pchote/Karaka/README.md

Karaka
======

Firmware and hardware schematics for the timing hardware in the [Puoko-nui time-series photometer](http://pchote.github.io/Puoko-nui/).

See the following documents for further details:
* [Puoko-nui manual](http://pchote.github.io/Puoko-nui/images/manual-lowres.pdf).
* [Firmware logic overview](https://github.com/pchote/Karaka/blob/master/doc/firmware.pdf?raw=true).
* [Board schematic](https://github.com/pchote/Karaka/blob/master/doc/schematic.pdf?raw=true).
