pchote/Karaka/doc/schematic.pdf

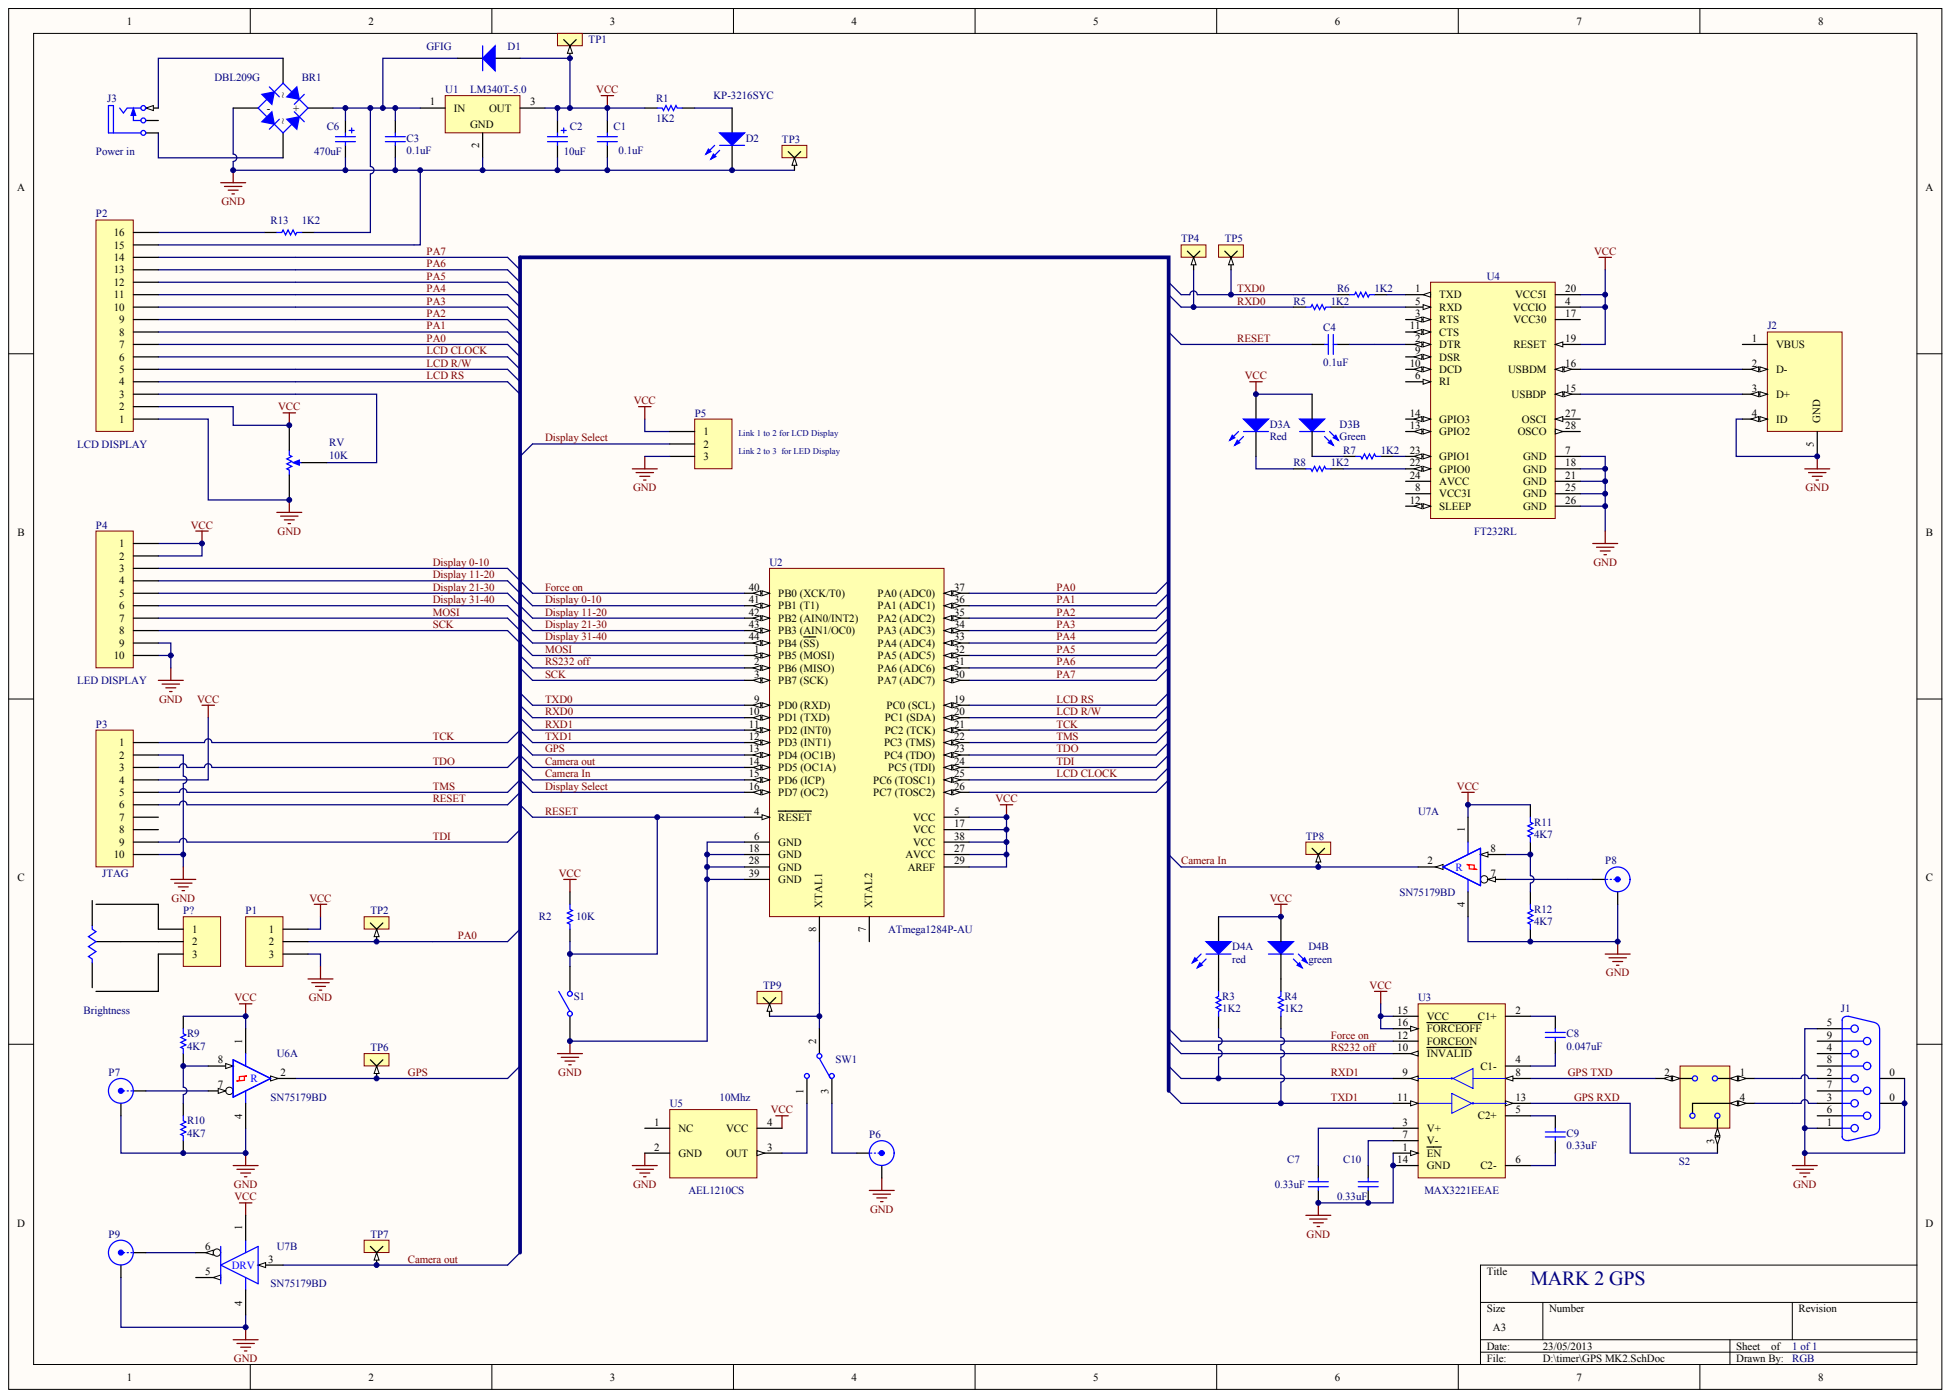
[picture p7: page 1]

Link 1 to 2 for LCD Displa

Link 2 to 3 for LED Displa
