pchote/Karaka/doc/layout.pdf

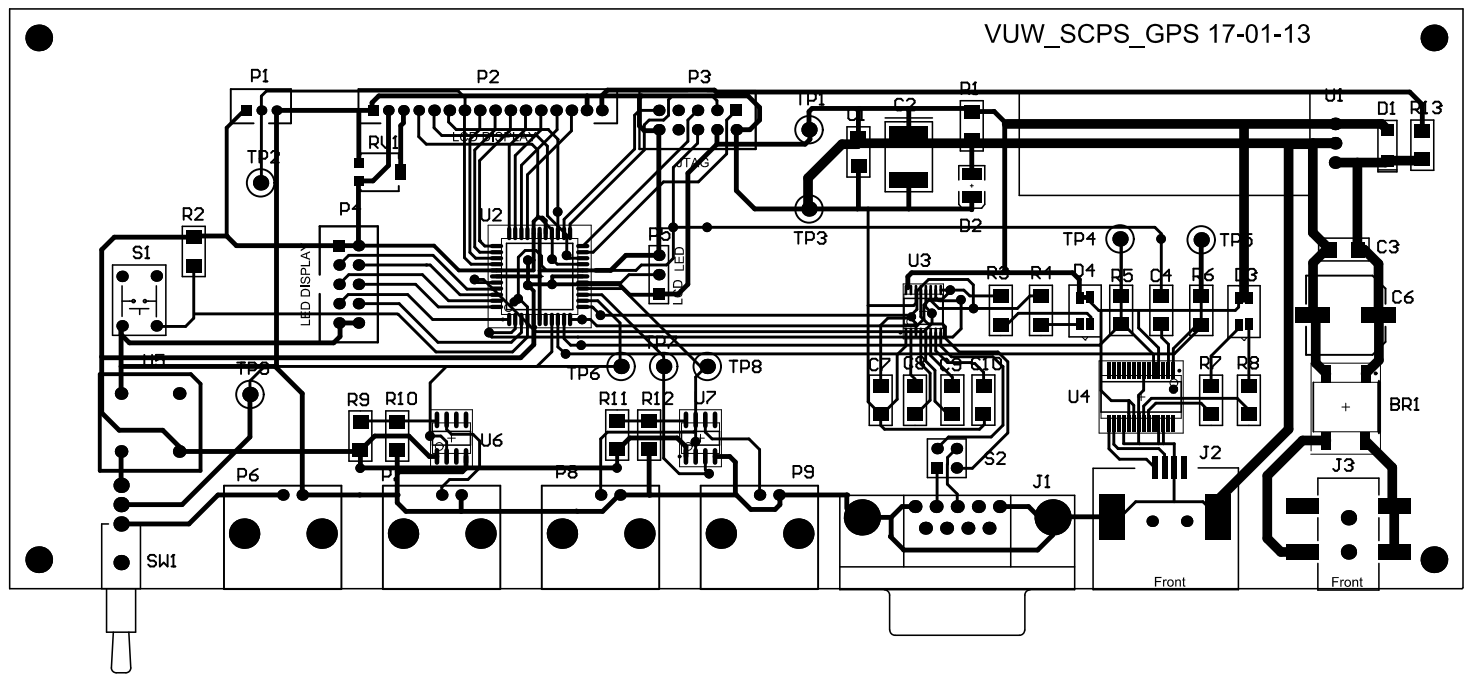
[picture p8: page 1]

Designator | Quantity | Value | Supplier 1 | Supplier Part Number 1
BR1 | 1 | DBL209G | Farnell | 1299302
C1a C3a C4 | 3 | 0.1uF
C2 | 1 | 10uF
C6 | 1 | 470uF
C7a C9a C10 | 3 | 0.33uF
C8 | 1 | 0.047uF
D1 | 1 | GFIG | Farnell | 9549595
D2 | 1 | KP-3216SYC | Farnell | 8529990
D3a D4 | 2 | | Farnell | 5790888
J1 | 1 | DB9 RA male plug | Farnell | 1099289
J2 | 1 | Connectora USB Ba SMTa R/A | Farnell | 1321918
J3 | 1 | | Farnell | 1889311
P1 | 1 | | Farnell | 4591598
P2 | 1 | | Farnell | 1830770
P3 | 1 | | Farnell | 8395918
P4 | 1 | | Farnell | 8395918
P5 | 1 | 3 x 1 berg stick 0.1 inch
P6a P7a P8a P9 | 4 | | Farnell | 1338762
R1a R3a R4a R5a R6a R7a R8a R13 | 8 | 1K2
R2 | 1 | 10K
R9a R10a R11a R12 | 4 | 4K7
RV | 1 | | Farnell | 1227539
S1 | 1 | | Farnell | 1656423
S2 | 1 | 2 x 2 berg stick 100ml
SW1 | 1 | | Farnell | 1082499
TP1a TP2a TP3a TP4a TP5a TP6a TP7a TP8a TP9 | 9 | | Farnell | 8731187
U1 | 1 | LM340T-5.0
U2 | 1 | ATmega1284P-AU | Farnell | 1715480
U3 | 1 | MAX3221EEAE | Farnell | 9725466
U4 | 1 | FT232RL | Farnell | 1146032
U5 | 1 | AEL1210CS | Farnell | 9509992
U6a U7 | 2 | SN75179BD | Farnell | 9592954
