pchote/Karaka/main.h

//***************************************************************************
//
//  File        : main.h
//  Copyright   : 2009-2012 Johnny McClymont, Paul Chote
//  Description : Main program logic
//
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
//***************************************************************************


#ifndef KARAKA_MAIN_H
#define KARAKA_MAIN_H

#include <string.h>
#include <stdint.h>
#include <stdbool.h>
#include <avr/io.h>

enum timing_mode
{
    MODE_PULSECOUNTER = 0,
    MODE_HIGHRES = 1,
};

extern uint8_t timing_mode;

// Run millisecond timer without a prescaler:
//   each tick is 0.1000us at 10MHz
//   each tick is 0.0625us at 16MHz
#define STOP_MILLISECOND_TIMER (TCCR1B = _BV(WGM12))
#define START_MILLISECOND_TIMER (TCCR1B = _BV(WGM12)|_BV(CS10))

// Bootloader bypass EEPROM parameters - must match definitions in bootloader.c
#define BOOTLOADER_EEPROM_OFFSET (uint8_t *)(0x00)
#define BYPASS_DISABLED 0xFF
#define BYPASS_ENABLED 0x42

// Relay mode EEPROM parameters
#define RELAY_EEPROM_OFFSET (uint8_t *)(0x01)
#define RELAY_DISABLED 0xFF
#define RELAY_ENABLED 0x42

extern uint16_t exposure_total;
extern volatile uint16_t exposure_countdown;
extern uint8_t trigger_stride;
extern volatile uint8_t trigger_countdown;
extern uint8_t align_boundary;
extern volatile uint16_t millisecond_count;

enum message_flags
{
    FLAG_SEND_STATUS       = _BV(0),
    FLAG_STOP_EXPOSURE     = _BV(1),
    FLAG_SEND_TIMESTAMP    = _BV(2),
    FLAG_SEND_TRIGGER      = _BV(3),
    FLAG_TIME_DRIFT        = _BV(4),
    FLAG_DUPLICATE_PULSE   = _BV(5),
    FLAG_MISSING_PULSE     = _BV(6),
};

extern volatile enum message_flags message_flags;

enum timestamp_flags
{
    TIMESTAMP_LOCKED = _BV(0),
    TIMESTAMP_IS_GPS = _BV(1)
};

struct timestamp
{
    uint16_t year;
    uint8_t month;
    uint8_t day;
    uint8_t hours;
    uint8_t minutes;
    uint8_t seconds;
    uint16_t milliseconds;
    enum timestamp_flags flags;
    int16_t utc_offset;
    uint16_t exposure_progress;
};

extern volatile struct timestamp download_timestamp;
extern struct timestamp current_timestamp;

enum timer_status
{
    TIMER_IDLE,
    TIMER_WAITING,
    TIMER_ALIGN,
    TIMER_EXPOSING,
    TIMER_READOUT,
    TIMER_RELAY
};

extern volatile enum timer_status timer_status;
void set_timer_status(enum timer_status status);

enum gps_status
{
    GPS_UNAVAILABLE = 0,
    GPS_SYNCING     = 1,
    GPS_ACTIVE      = 2
};

extern volatile enum gps_status gps_status;
void set_gps_status(enum gps_status status);

void set_time(struct timestamp *t);

#endif
