pchote/Karaka/usb.h

//***************************************************************************
//
//  File        : usb.h
//  Copyright   : 2013 Paul Chote
//  Description : Handles communication with the Acquisition PC via serial
//
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
//***************************************************************************

#include <stdarg.h>
#include <stdint.h>

#ifndef KARAKA_USB_H
#define KARAKA_USB_H

void usb_initialize();
void usb_tick();

void usb_send_message_P(const char *string);
void usb_send_message_fmt_P(const char *fmt, ...);
void usb_send_raw(uint8_t *data, uint8_t length);
void usb_send_timestamp();
void usb_send_trigger();
void usb_send_status(enum timer_status timer, enum gps_status gps);
void usb_stop_exposure();

void usb_send_byte(uint8_t b);

#endif
