pchote/Karaka/(commit log)

2011-01-13 Rename timer2 -> msec_timer.
2011-01-14 Rename timer0 -> sync_pulse and clean it up.
2011-01-14 Document what each port/pin does.
2011-01-17 Refactor display code. Functional change: LCD refresh timer is reset and continues running while the display state is refreshed. It used to be stopped and restarted after this completed.
    [display.c, display.h, main.c, main.h]
2011-01-17 Keep track of the last displayed header instead of manually resetting it.
    [display.c, display.h, main.c, main.h]
2011-01-17 Fix a typo in main.c (& should be && in SIG_INTERRUPT0) which could lead to sync pulses being sent to the camera when the gps time isn't good. More general refactoring.
    [main.c, main.h]
2011-01-17 Refactor and document timer usage.
2011-01-17 Rewrite and simplify the useful bits of UART_Math into main.c and command.c.
2011-01-17 Fix naming conventions in command.c/h.
    [main.h]
2011-01-17 Fix Delay (period was completely wrong) and remove more unused header files
    [display.c, display.h, main.c, main.h]
2011-01-17 Fix/tidy gps pulse / datastream interaction for syncpulses.
    [gps.c, gps.h, main.c, main.h]
2011-01-19 Use the packet length to determine when the end of a packet has been reached. Fixes a bug where packets containing the number 10 (0x0A) were truncated.
    [display.c, gps.c, gps.h]
2011-01-19 Implement 10s boundary, be more explicit about stale timestamps, fix more naming.
    [display.c, display.h, gps.c, gps.h, main.c, main.h]
2011-03-31 Refactor gps serial parsing out of the interrupt onto the main loop
2011-04-01 Use interrupt driven usart transmission. Send the timestamp via usart when it changes. remove the old command interface. remove gps watcher timeout (it didn't work).
    [display.c, display.h, gps.c, gps.h, main.c]
2011-04-04 Rework data sending to acquisition pc. Use the trimble frame format, but use a different format for the timestamp data
    [display.c, display.h, main.c, main.h]
2011-04-06 Change exposure_count and exposure_total to unsigned chars (limits exposure length to ~4 minutes), refine acquisition data packets to have non-conflicting ids and the current timestamp include counte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
2011-04-11 Remove the unused millisecond timer code
2011-04-12 Move pin I/O setup from main.c into each of the submodules.
2011-04-12 Remove unnecessary interrupt setup.
2011-04-13 Make variables changed by pps interrupt volatile (hopefully fixes delayed-by-1s download times)
    [gps.h, main.h]
2011-04-14 Send debug when skipping bytes while syncing
    [gps.c]
2011-04-15 gps transmission using interrupts
2011-08-04 Change the download trigger to rest high, and pull low to trigger a download. The open-circuit state of the camera input is high, so using negative edge triggering adds resilience to cable faults (pr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
2011-08-21 Initial support for monitoring the not-scan output on the camera for monitoring download status, and running the camera shutdown logic in the acquisition program via the timer to prevent shutdown whi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
    Incomplete.
    [download.h, main.c]
2011-08-22 Debounce the monitor to prevent spurious triggering
    [main.c]
2011-08-22 Route camera sequence start/stop via the timer to prevent the acquisition program from stopping a sequence while the camera is downloading, and to prevent the timer from sending download pulses befor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
    [main.c]
2011-08-23 Improve the exposure boundary syncing to ensure that the frames will always align (at some point) with the minute boundary.
2011-09-15 Remove PPS interrupt enabling/disabling - keep it permanently enabled. Replace exposure_syncing with countdown_mode with an extra TRIGGERED state which is used to detect additional PPS pulses arrivin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
    [gps.c, main.c, main.h]
2011-09-15 Add two bytes to START_EXPOSURE and STOP_EXPOSURE. The first determines whether to use the monitoring circuit in the new timer unit; the second specifies a fixed delay to wait before continuing if no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
    [main.c, main.h]
2011-09-18 Replace crazy DIY number formatting with sprintf
    [display.c]
2011-09-21 Add a timer to monitor GPS serial connection loss; Rename state constants.
2011-10-26 Make the magellan init more robust - disable the messages that the OEM software may have previously enabled; prevent data from being lost when long messages are sent.
    [gps.c]
2011-10-27 Fix indentation: replace tabs with spaces
    [display.c, display.h, download.h, gps.c, gps.h, main.c]
2011-10-31 Fix trimble timestamp parsing
    [gps.c]
2011-10-31 Add trimble manual and hardware schematics
2012-02-16 Add manual for the atmega1284p & updated board schematic
2012-02-16 Update code for new board design. Have removed incompatible display code - replacement TBD.
    [display.c, display.h, download.h, gps.c, main.c]
2012-02-16 Cleanup PC communication code & increase baud rate to 250k to reduce errors.
    [gps.c, main.c]
2012-02-16 Remove obsolete and buggy fixed delay when starting and stopping exposure sequences
    [main.c, main.h]
2012-02-16 Make the distinction between initializing hardware and resetting state explicit. Reset packet should now reset all appropriate state.
    [display.c, display.h, download.h, gps.c, gps.h, main.c, main.h]
2012-02-16 Simplify the PC<->timer communication protocol - Fixes ignoring first packet when syncing - Fixes ignored packets when length or checksum = 0x10 - More readable when viewing raw data via minicom - Re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
2012-03-05 Use the spare output and timer to fake the camera status output for testing
2012-03-05 Redesign display output. Simplify redraw logic to "every second (determined from serial data) or whenever GPS state changes".
    [display.c, gps.c, gps.h, main.c]
2012-03-05 monitor_mode and gps_state can be modified via interrupt so should be volatile.
2012-03-05 Clear GPS and command state on reset
    [gps.c, gps.h, main.c]
2012-03-05 Don't send command packets from within interrupts.
2012-03-05 Warn on duplicate/missing PPS, but don't change the countdown
    [gps.c, main.c, main.h]
2012-03-05 Use software interrupts for simulated camera status. This allows all units to use the monitor/fakecamera code, including the original unit without the monitor input. The acquisition software can send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
2012-03-05 Disable monitor debounce timer on reset
2012-04-11 Fix a potential rounding bug / underflow error
    [gps.c]
2012-04-25 Fix Trimble DLE stripping for repeated DLEs (e.g. timestamp of 16:16:16)
    [gps.c]
2012-07-23 Rework magellan time offset to fix leap years and an overflow
    [gps.c]
2012-10-23 Fix compilation with gcc 4.7
    [display_led.c, gps.c, main.c]
2012-10-23 Hack in a "Relay" mode for GPS signal passthrough.
    When in relay mode:
    - All GPS pulses enable a trigger.
    - USB baud rate is set to 9600.
    - GPS serial data is forwarded directly to the PC.
    - PC serial data is forwarded directly to the GPS.
    - Return to normal mode by cycling power (TODO: Fix this).
    [display_led.c, gps.c, gps.h, main.c, main.h]
2012-10-29 Parse and display time while in relay mode
2012-10-29 Exit relay mode by sending 256 0's.
2012-11-01 Change download and monitor timers to use output compare.
2012-11-01 Use timer3 for both real and simulated monitoring.
2012-11-01 Switch serial timeout watcher from timer1 to timer2.
2012-11-01 Send a download trigger on the first alignment.
    This avoids an unnecessary 1-frame delay.
    [display_led.c, gps.c, main.c, main.h]
2012-11-10 Fix compilation for the atmega128
    [gps.c]
2012-11-13 Remove unnecessary interrupt disables from command.c
2012-11-13 Save and restore SREG when disabling interrupts.
2012-11-14 Rework makefile targets.
    Valid targets:
    all: builds bootloader.hex, main.hex
    install: installs main.hex via bootloader
    bootloader: installs bootloader.hex via JTAG
    fuse: set processor fuses via JTAG
    debug: debug application via JTAG
    debug-bootloader: debug bootloader via JTAG
    clean: removes build intermediates and products
2012-11-19 Fix bootloader for atmega128
    [bootloader.c]
2012-11-19 Rework LED display
2012-11-20 Extract sending timestamps to main loop.
    This adds an small additional latency, but works towards
    minimizing the changes between regular and millisecond modes.
2012-11-20 Rename FLAG_DUPLICATE_PULSE -> FLAG_TIME_DRIFT to match millisecond mode
2012-11-20 Change timestamp format. Requires matched acquisition change.
    - Specify date before time
    - Include milliseconds (always zero for non-millisecond mode)
    - Specify exposure progress as increasing count
2012-11-20 Trigger PPS interrupt on the falling edge of the pulse
2012-11-20 Make download_timestamp volatile.
    This is needed for millisecond mode, and does no harm being included in regular mode.
2012-11-20 Change reset packets to do a full hardware restart.
    [display.h, display_led.c, download.h, gps.c, gps.h, main.c, main.h]
2012-11-20 Simplify relay mode reset check.
2012-11-22 Save a few instructions in ADC interrupt.
    The standard mandates that bitwise operations promote
    to a (16-bit) int. Casting to uint8 hints to the compiler
    that it can use 8 bit operations.
2012-11-26 Align 10MHz high-res timing to within 100ns of PPS.
    Also tweaked the 16MHz timing to be more correct,
    but the internal oscillator isn't stable enough
    to be able to judge this correctly.
    [main.c]
2013-01-28 Change Bootloader to use a timeout instead of eeprom flag.
    The new hardware uses the DTR control signal to initiate
    a hardware reset, so we can reset and immediately fire
    data at the bootloader to handle an upgrade without
    worrying about corrupted EEPROM booting into an inoperable
    state.
    [bootloader.c, main.c, main.h, reset.c]
2013-01-29 Support DTR reset under Windows.
    [reset.c]
2013-01-30 Fix relay mode with new hardware.
    The GPS software triggers a DTR and immediately sends
    configuration data to the GPS, which puts the timer
    into the bootloader. This adds a bypass to skip the
    bootloader, while ensuring that we can always return
    to the bootloader (by toggling DTR again).
    timerutil --relay must now be run every time before
    launching the GPS configuration software.
    [bootloader.c, main.c, main.h]
2013-02-16 Move relay mode into timer_status to simplify display.
2013-02-16 Increase LCD startup delay, which appears to solve display issues.
    [display.c]
2013-02-16 Move missing pulse warning to main loop.
    [main.c, main.h]
2013-02-16 Enable brown-out detection at 4.5V.
2013-02-16 current_timestamp is accessed from an interrupt.
2013-02-16 Remove duplicated code from pulse interrupt.
2013-02-16 Rename interrupt_flags -> message_flags.
2013-02-17 Tidy camera.{c,h}.
2013-02-18 Prevent all timer messages (not just PPS) in relay mode.
    [main.c]
2013-02-18 Tweak monitor interrupt to match logic diagram.
2013-02-19 Adjust millisecond timer phase by -11us.
    The change from rising to falling edge interrupt
    for the 1Hz input introduced a ~10-11us offset
    (the pulse width), which this counteracts.
2013-03-26 Increase bootloader timeout to 4s to avoid issues on the UT acquisition PC.
    [bootloader.c]
2013-04-24 Interpolate timestamps to reduce data transmission.
    Caveats:
    - Only 1 in N triggers are sent to verify frame times against
    - Camera status updates are disabled if exptime < 500ms
2013-05-09 Fix boundary alignment for exposures > 60s. Fixes #20.
    [usb.c]
2013-05-26 Add board layout and schematic pdfs.
2018-12-16 Add 1024 week rollover fix for Trimble receiver.
    [gps.c]
