pchote/Karaka/(notices)

Notices in the files:
usb.c:
to you under the terms of version 3 of the GNU General Public License, as
published by the Free Software Foundation. For more information, see LICENSE.
